guyilherme/drybox_caseira/(commit log)

2026-10-17 feat: adequacao do firmware, platformio e manual para ESP32-S3 N16R8 e hardware real
2026-10-17 docs: adiciona esquema visual de ligacao dos mosfets em portugues (html, svg e mermaid)
2026-10-17 docs: adiciona calculo de dimensionamento de bitolas de cabos e guia de compra
2026-10-18 docs: adiciona esquema eletrico interativo completo de ponta a ponta do sistema (HTML/SVG)
2026-10-18 fix: corrige funcao de filtro de barramentos no esquema interativo do sistema
2026-10-18 fix: adiciona todas as trilhas e fios de ligacao ponto a ponto conectando bornes e componentes no esquema do sistema
2026-10-18 fix(schematic): corrige tags SVG invalidas que ocultavam toda a fiacao e alinha coordenadas ponta a ponta
2026-10-18 feat(pcb): adiciona projeto completo de placa mae carrier shield para PCBWay com gerbers kicad e visualizador interativo
    [drybox_motherboard-B_Cu.gbl, drybox_motherboard-B_Mask.gbs, drybox_motherboard-B_Silkscreen.gbo, drybox_motherboard-Edge_Cuts.gbr, drybox_motherboard-F_Cu.gtl, drybox_motherboard-F_Mask.gts, drybox_motherboard-F_Silkscreen.gto, drybox_motherboard.drl]
2026-10-18 refactor(docs): converte todos os links e caminhos para relativos tornando o repositorio 100% portavel
2026-10-18 feat(pcb): adiciona serigrafia vetorial completa com nomes e pinagens de todos os componentes na placa
    [drybox_motherboard.kicad_pcb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]
2026-10-18 fix(pcb): corrige posicionamento da serigrafia do ESP32 e afasta titulo dos furos M3
    [drybox_motherboard.kicad_pcb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]
2026-10-20 feat: implement ESP32-S3 firmware and hardware design files for Drybox 60L controller
